scottrosenquist/crkbd/corne-scott/pcb/corne-light.kicad_pcb

## KiCad design corne-scott/pcb/corne-light.kicad_pcb (2020-04-27)

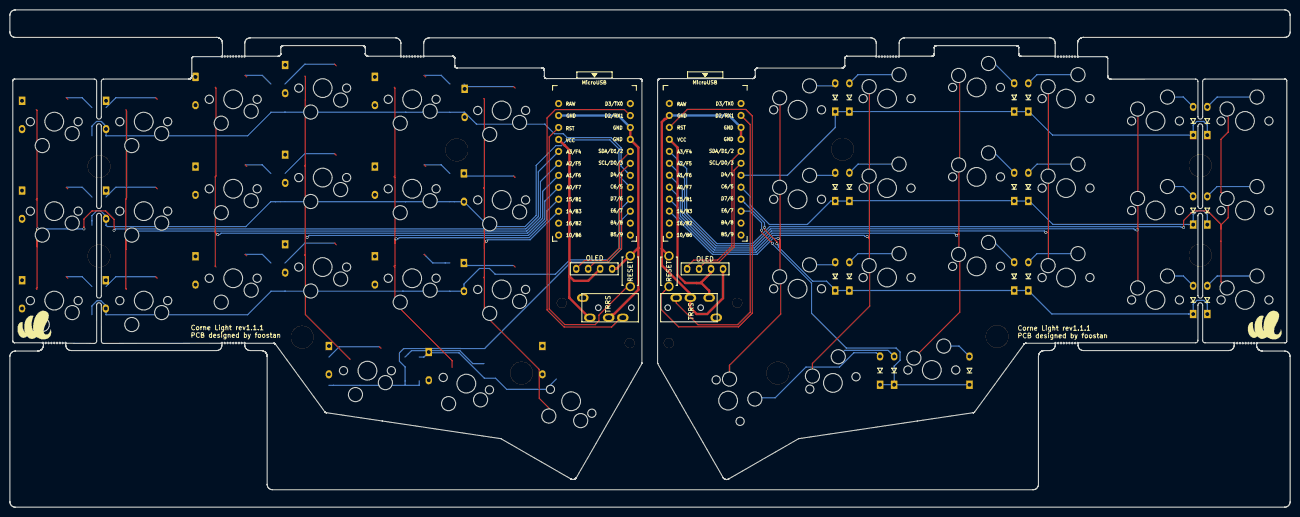
[picture p1: board corne-light.kicad_pcb from above]

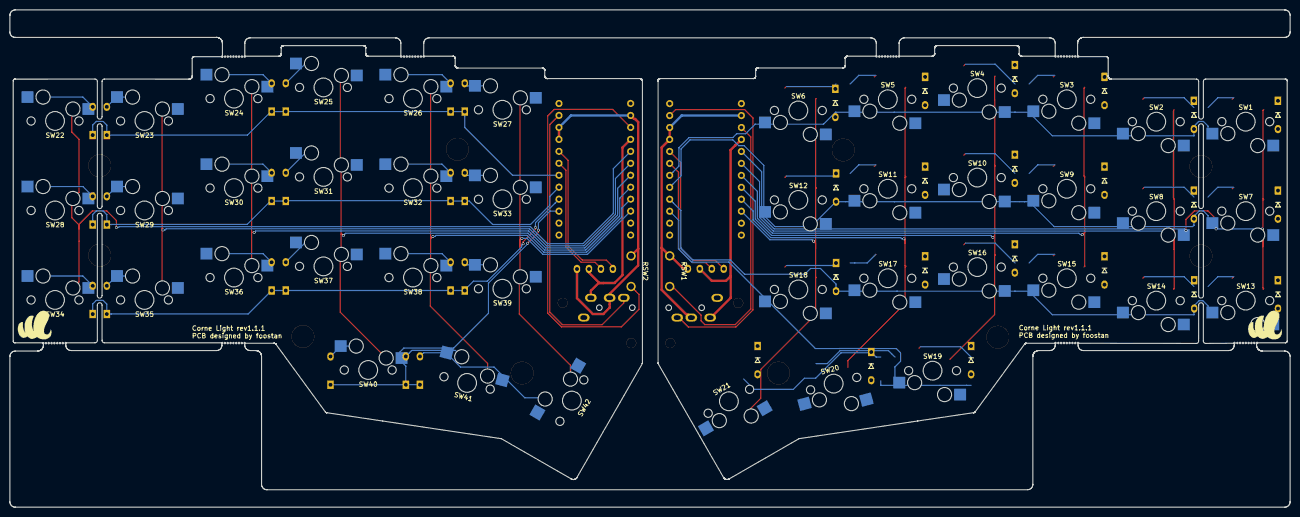
[picture p2: board corne-light.kicad_pcb from below]

Board: 2 copper layers, 271.8 x 105.6 mm, 114 parts (28 on the bottom side), 74 nets.

Parts:
D1, D2, D3, D4, D5, D6, D7, D8, D9, D10, D11, D12, D13, D14, D15, D16, D17, D18, D19, D20, D21, D22, D23, D24, D25, D26, D27, D28, D29, D30, D31, D32, D33, D34, D35, D36, D37, D38, D39, D40, D41, D42: D; D3_TH
J1, J6: MJ-4PP-9; MJ-4PP-9_1side
J2, J7: OLED; OLED_1side
J5, J5#2, J5#3, J5#4, J5#5, J5#6, J5#7, J5#8: Breakaway_Tabs; breakaway-mousebites
RSW1, RSW2: SW_PUSH; ResetSW_1side
Ref**: Val**; M2_Threads_v2
Ref**#2, Ref**#3, Ref**#4: Val**; M2_Threads_v2
Ref**#5, Ref**#6, Ref**#7, Ref**#8, Ref**#9, Ref**#10, Ref**#11, Ref**#12, Ref**#13, Ref**#14: Val**; M2_HOLE_v2
SW1, SW2, SW3, SW4, SW5, SW6, SW7, SW8, SW9, SW10, SW11, SW12, SW13, SW14, SW15, SW16, SW17, SW18, SW19, SW20, SW21, SW22, SW23, SW24, SW25, SW26, SW27, SW28, SW29, SW30, SW31, SW32, SW33, SW34, SW35, SW36, SW37, SW38, SW39, SW40, SW41, SW42: SW_PUSH; MXOnly-1U-Hotswap
U1, U2: ProMicro; ProMicro_v3

Connections:
GND: J1.C, J2.4, RSW1.2, U1.3, U1.4, U1.23
GNDA: J6.C, J7.1, RSW2.2, U2.3, U2.4, U2.23
unnamed: D1.2, SW1.2
unnamed: D2.2, SW2.2
unnamed: D3.2, SW3.2
unnamed: D4.2, SW4.2
unnamed: D5.2, SW5.2
unnamed: D6.2, SW6.2
unnamed: D7.2, SW7.2
unnamed: D8.2, SW8.2
unnamed: D9.2, SW9.2
unnamed: D10.2, SW10.2
unnamed: D11.2, SW11.2
unnamed: D12.2, SW12.2
unnamed: D13.2, SW13.2
unnamed: D14.2, SW14.2
unnamed: D15.2, SW15.2
unnamed: D16.2, SW16.2
unnamed: D17.2, SW17.2
unnamed: D18.2, SW18.2
unnamed: D19.2, SW19.2
unnamed: D20.2, SW20.2
unnamed: D21.2, SW21.2
unnamed: D22.2, SW22.2
unnamed: D23.2, SW23.2
unnamed: D24.2, SW24.2
unnamed: D25.2, SW25.2
unnamed: D26.2, SW26.2
unnamed: D27.2, SW27.2
unnamed: D28.2, SW28.2
unnamed: D29.2, SW29.2
unnamed: D30.2, SW30.2
unnamed: D31.2, SW31.2
unnamed: D32.2, SW32.2
unnamed: D33.2, SW33.2
unnamed: D34.2, SW34.2
unnamed: D35.2, SW35.2
unnamed: D36.2, SW36.2
unnamed: D37.2, SW37.2
unnamed: D38.2, SW38.2
unnamed: D39.2, SW39.2
unnamed: D40.2, SW40.2
unnamed: D41.2, SW41.2
unnamed: D42.2, SW42.2
SCL: J2.2, U1.6
SCL_r: J7.3, U2.6
SDA: J2.1, U1.5
SDA_r: J7.4, U2.5
VCC: J1.D, J2.3, U1.21
VDD: J6.D, J7.2, U2.21
col0: SW1.1, SW7.1, SW13.1, U1.20
col0_r: SW22.1, SW28.1, SW34.1, U2.20
col1: SW2.1, SW8.1, SW14.1, U1.19
col1_r: SW23.1, SW29.1, SW35.1, U2.19
col2: SW3.1, SW9.1, SW15.1, U1.18
col2_r: SW24.1, SW30.1, SW36.1, U2.18
col3: SW4.1, SW10.1, SW16.1, SW19.1, U1.17
col3_r: SW25.1, SW31.1, SW37.1, SW40.1, U2.17
col4: SW5.1, SW11.1, SW17.1, SW20.1, U1.16
col4_r: SW26.1, SW32.1, SW38.1, SW41.1, U2.16
col5: SW6.1, SW12.1, SW18.1, SW21.1, U1.15
col5_r: SW27.1, SW33.1, SW39.1, SW42.1, U2.15
data: J1.B, U1.2
data_r: J6.B, U2.2
reset: RSW1.1, U1.22
reset_r: RSW2.1, U2.22
row0: D1.1, D2.1, D3.1, D4.1, D5.1, D6.1, U1.7
row0_r: D22.1, D23.1, D24.1, D25.1, D26.1, D27.1, U2.7
row1: D7.1, D8.1, D9.1, D10.1, D11.1, D12.1, U1.8
row1_r: D28.1, D29.1, D30.1, D31.1, D32.1, D33.1, U2.8
row2: D13.1, D14.1, D15.1, D16.1, D17.1, D18.1, U1.9
row2_r: D34.1, D35.1, D36.1, D37.1, D38.1, D39.1, U2.9
row3: D19.1, D20.1, D21.1, U1.10
row3_r: D40.1, D41.1, D42.1, U2.10
