scottrosenquist/crkbd/(commit log)

2020-04-26 Initial commit-ish
    [corne-light.kicad_pcb, corne-light.sch]
2020-04-27 Make switches hotswap
    [corne-light.kicad_pcb]
2020-04-27 Rotate left side switches and diodes
    [corne-light.kicad_pcb]
2020-04-27 Adjust left side diodes
    [corne-light.kicad_pcb]
2020-04-27 Add back reset switches I accidentally turned into mx switches
    [corne-light.kicad_pcb]
